FeruzTopalov/ds18b20-pocket-thermo/ds18b20_tn2313a schematic.PNG

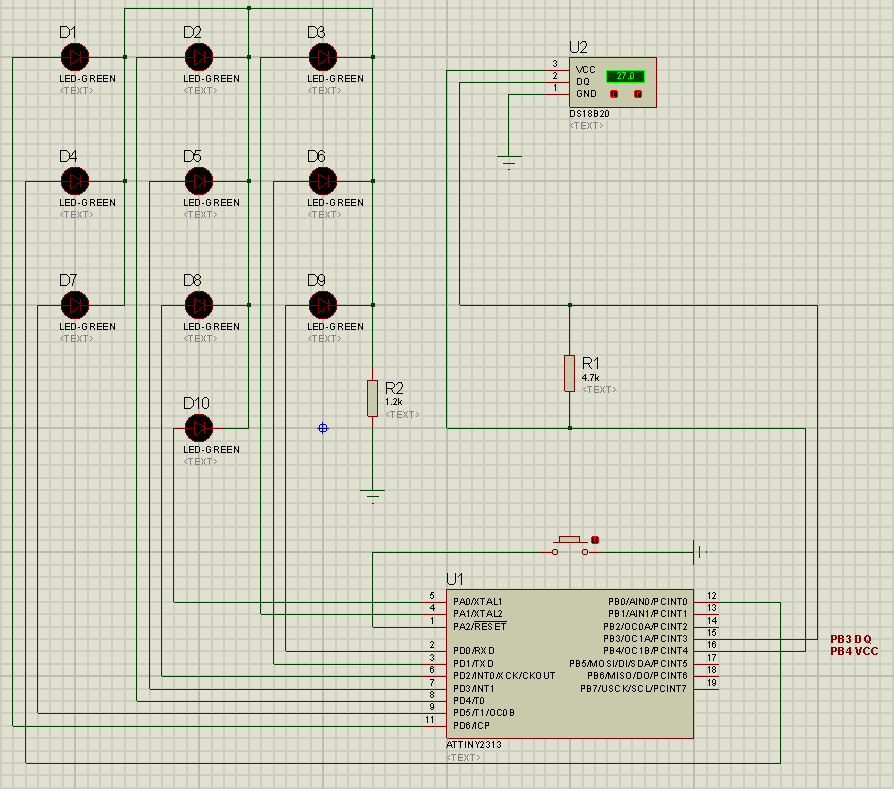
ds18b20_tn2313a schematic.PNG
