FeruzTopalov/ds18b20-pocket-thermo/(list of files, drawings)

Other design files:
LAYOUT/ds18b20_tn2313a.lay6
PROTEUS/ds18b20_tn2313a.DSN
